dinuka-eng/fury-vertical-spinner/images/fury_top_view_arena.jpeg

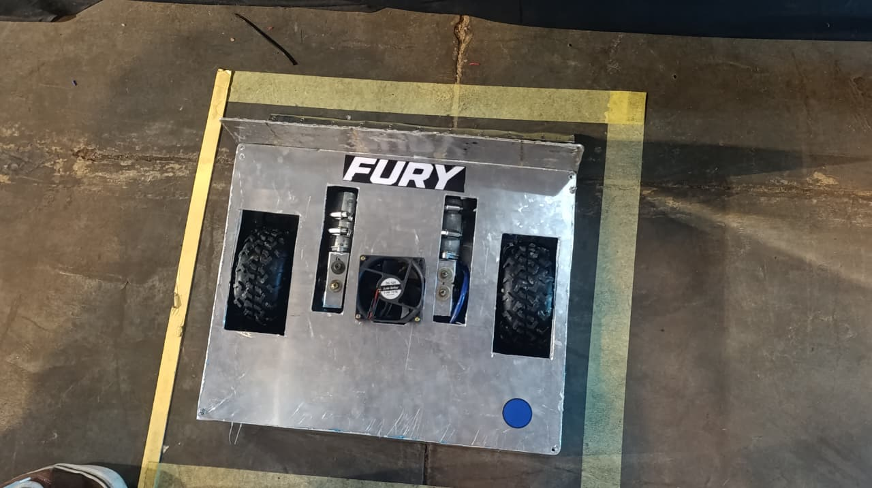
images/fury_top_view_arena.jpeg
