dinuka-eng/fury-vertical-spinner/images/fury_side_wedge_with_transmitter.jpeg

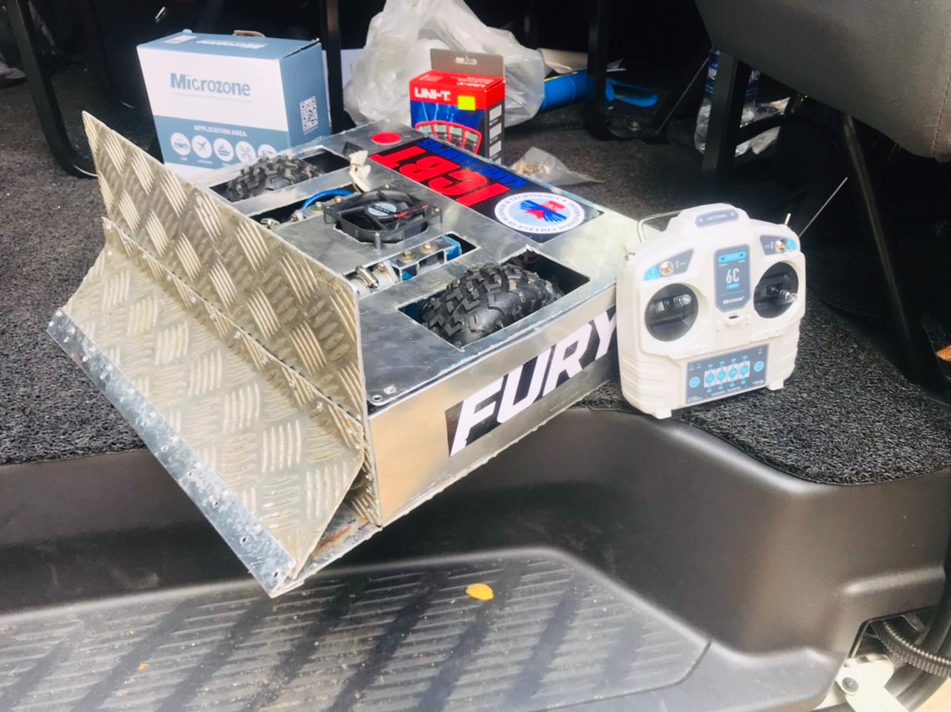
images/fury_side_wedge_with_transmitter.jpeg
