dinuka-eng/fury-vertical-spinner/electrical/README.md

# Electrical files

Add schematics and sources here as they are produced (KiCad or Proteus project files plus PDF exports):

1. Power distribution — battery, fuse, master switches, buck converter, ESC and IBT-2 supplies
2. Controller — ESP32, receiver connections, pull-downs, armed LED
3. Drivers — IBT-2 connections, ESC wiring (BEC wire removed)

Pin map and wiring rules are in [`../docs/ELECTRICAL.md`](../docs/ELECTRICAL.md).
