dinuka-eng/fury-vertical-spinner/images/fury_front_wedge_open.jpeg

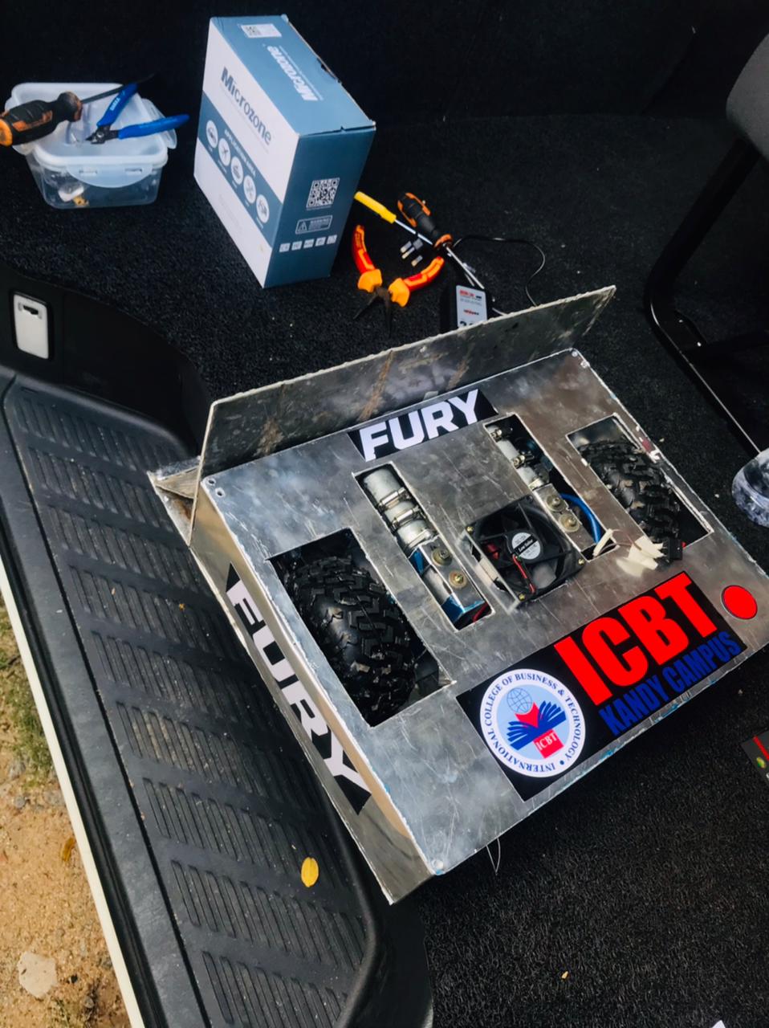
images/fury_front_wedge_open.jpeg
